vibheshmodgil/gimbal/docs/live_probe_pan_left.jpg

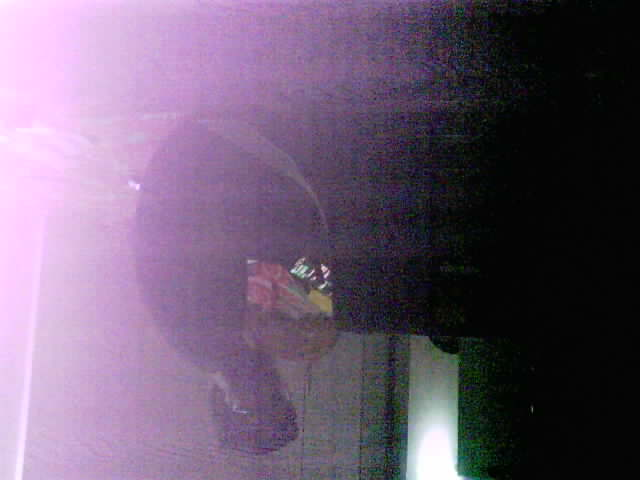
docs/live_probe_pan_left.jpg
