vibheshmodgil/gimbal/docs/live_probe_tilt_up.jpg

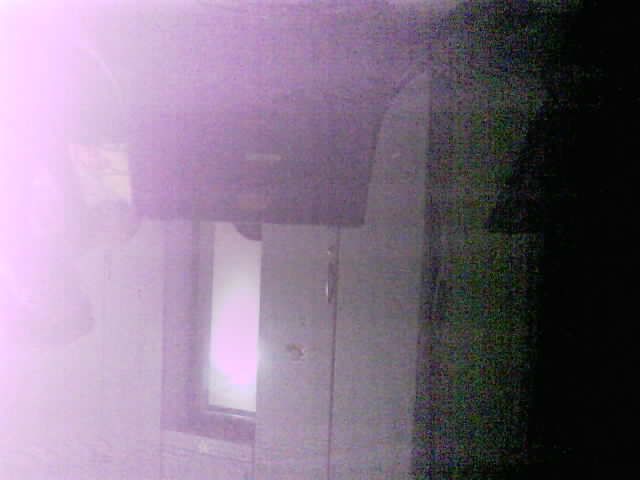
docs/live_probe_tilt_up.jpg
