vibheshmodgil/gimbal/docs/live_probe_frame.jpg

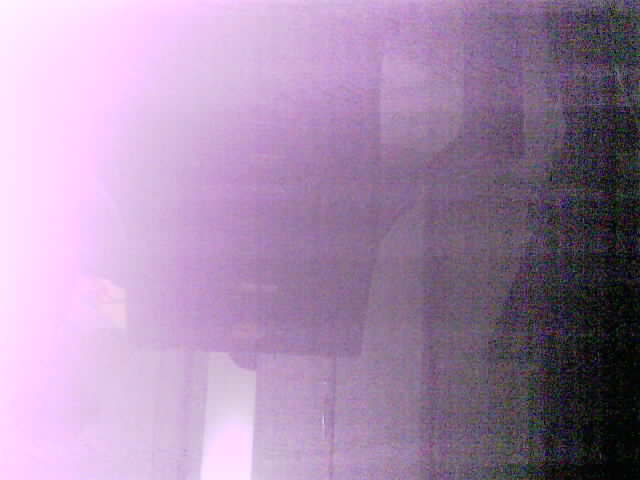
docs/live_probe_frame.jpg
