vibheshmodgil/gimbal/docs/live_probe_pan_right.jpg

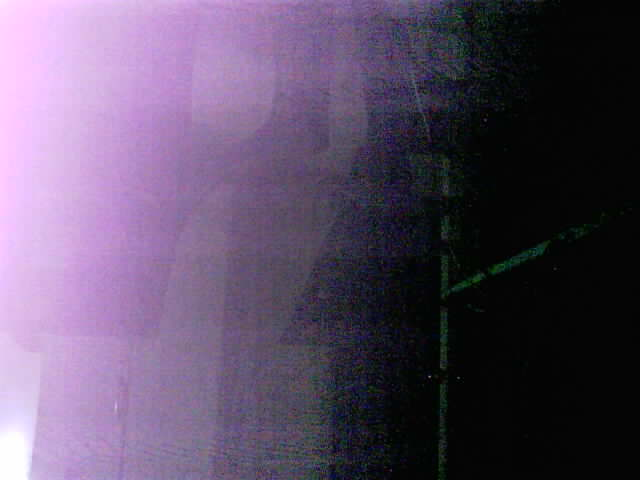
docs/live_probe_pan_right.jpg
