vibheshmodgil/gimbal/docs/previews/preview.png

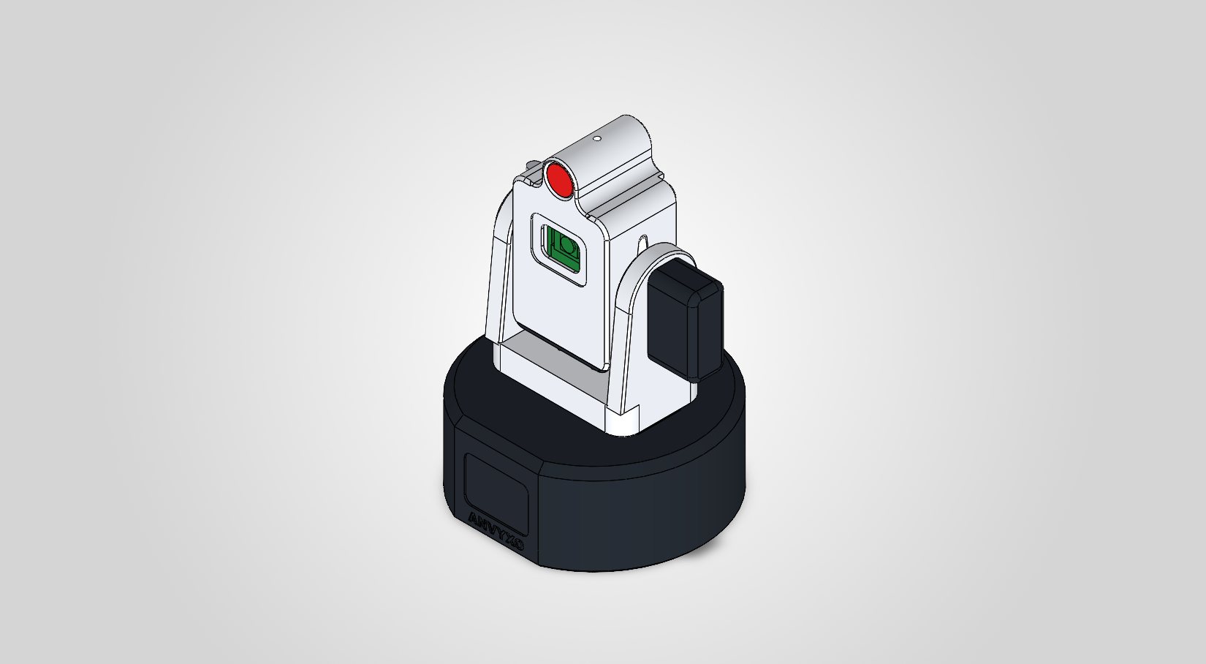
docs/previews/preview.png
