vibheshmodgil/gimbal/docs/previews/preview_back.png

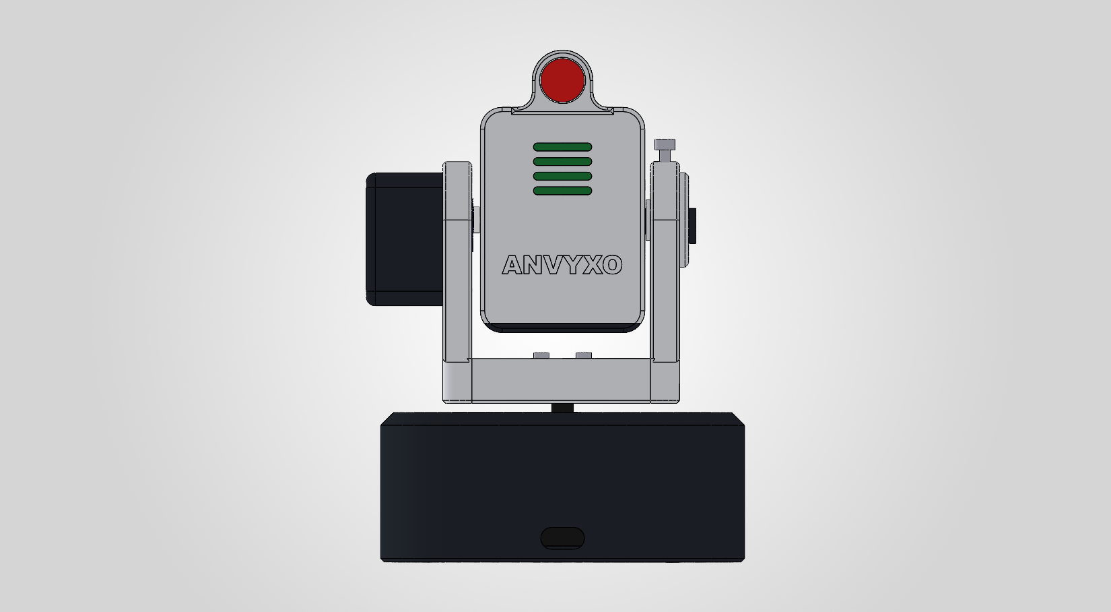
docs/previews/preview_back.png
