vibheshmodgil/gimbal/docs/previews/preview_exploded.png

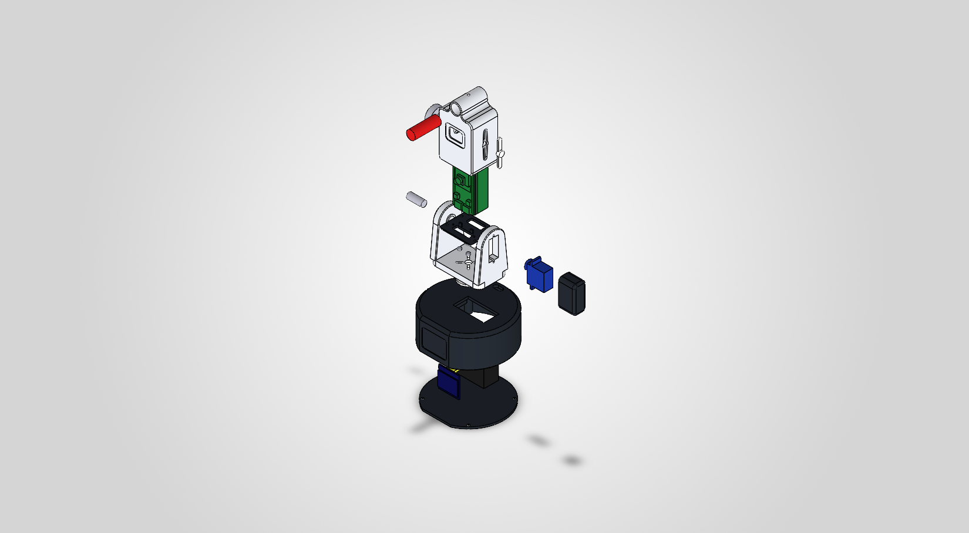
docs/previews/preview_exploded.png
