vibheshmodgil/gimbal/docs/previews/preview_front.png

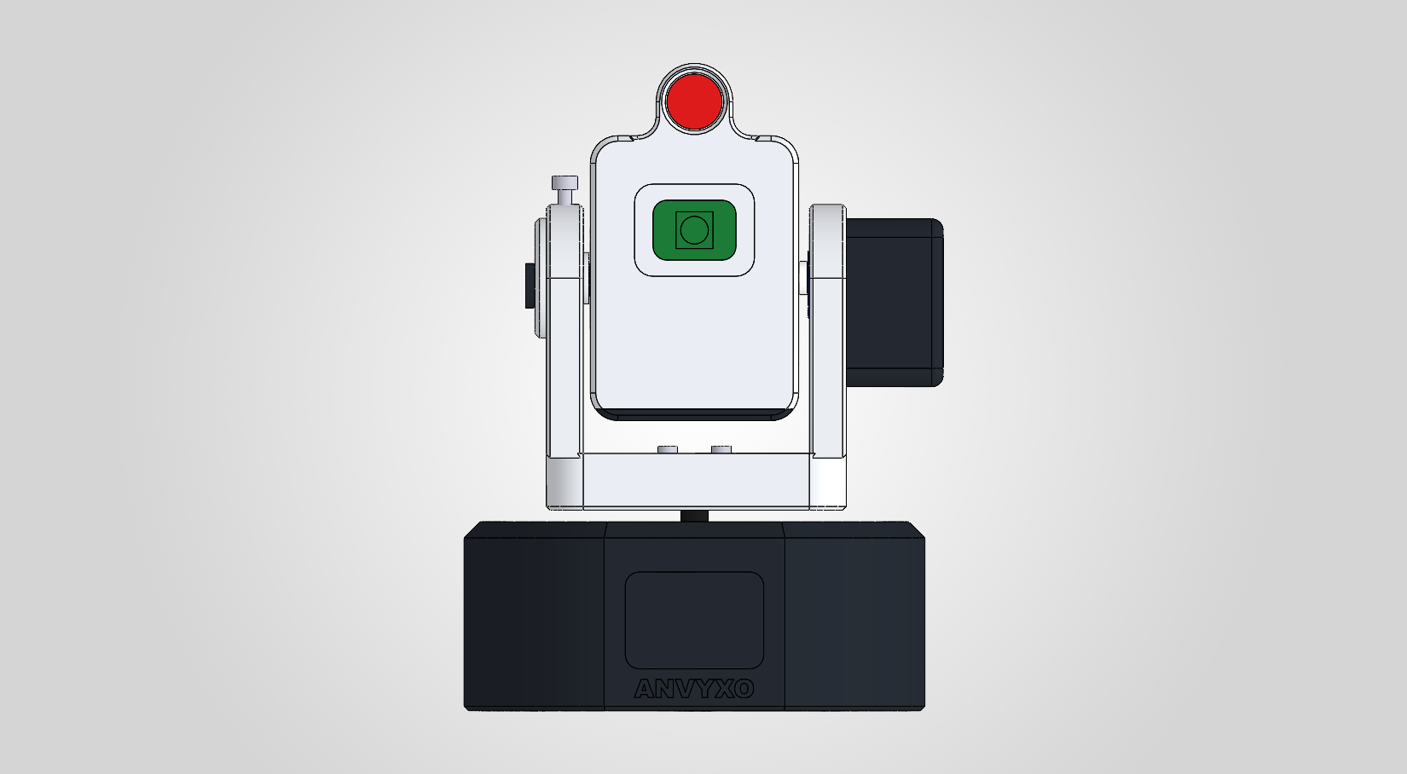
docs/previews/preview_front.png
