vibheshmodgil/gimbal/STEP/gimbal_assembly.step

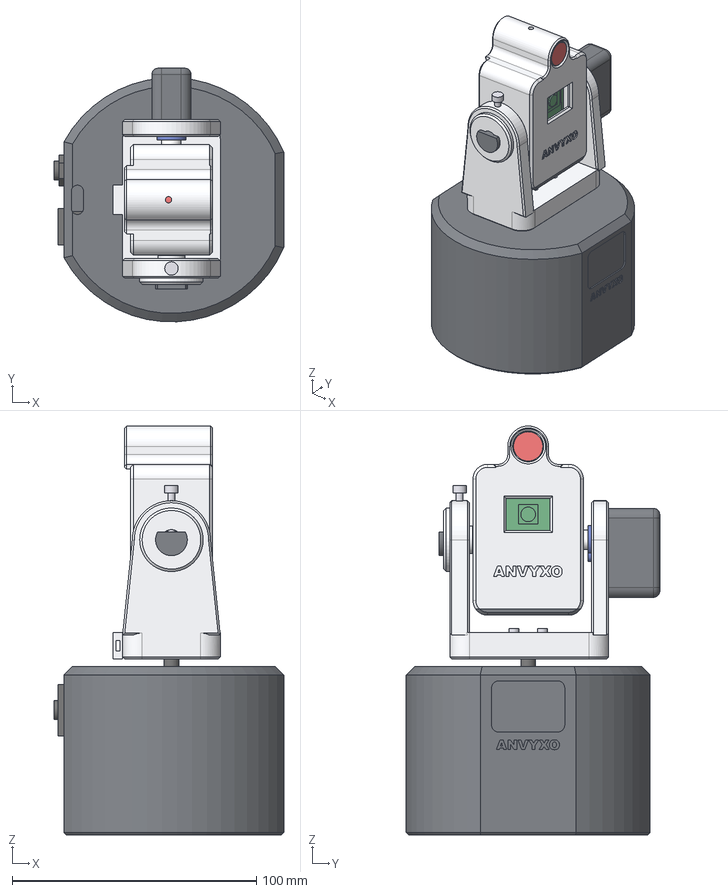
[picture p9: CAD file, 2026-10-19]
STEP/gimbal_assembly.step
94.0 x 103.8 x 167.5 mm
base
bottom_plate
yoke
servo_cap
axle_pin
head
head_floor
BUY_MG996R
BUY_MG996R_horn
BUY_horn_screws
BUY_MG90S
BUY_MG90S_horn
BUY_608ZZ
BUY_M3_lock_screw
BUY_laser_12mm
BUY_ESP32S3_CAM
BUY_OLED_096
BUY_OLED_header_dupont
BUY_battery_3S_BMS
BUY_buck_5V
BUY_WAGO_x2
BUY_cap_1000uF
BUY_rocker_switch
BUY_dc_jack
BUY_dc_jack_nut
