vibheshmodgil/gimbal/PRINT_BambuLab/5_REPRINT_axle_pin_A1.3mf

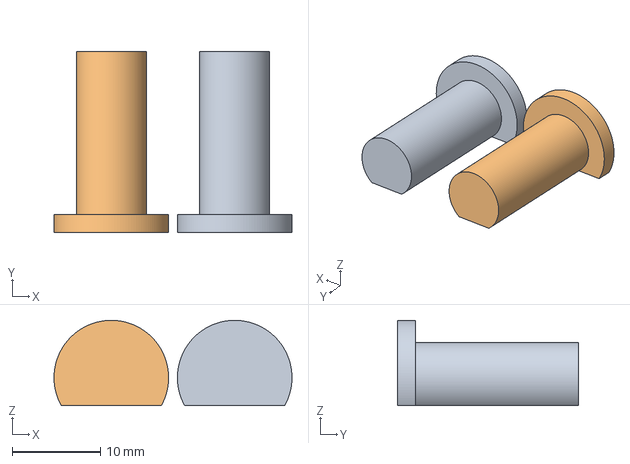
[picture p10: CAD file, 2026-10-19]
PRINT_BambuLab/5_REPRINT_axle_pin_A1.3mf
27.0 x 20.5 x 9.68 mm
stl_oriented/axle_pin.stl x 2
