vibheshmodgil/gimbal/PRINT_BambuLab/other_printers_geometry_only/plate1_fit_tests_any_colour.3mf

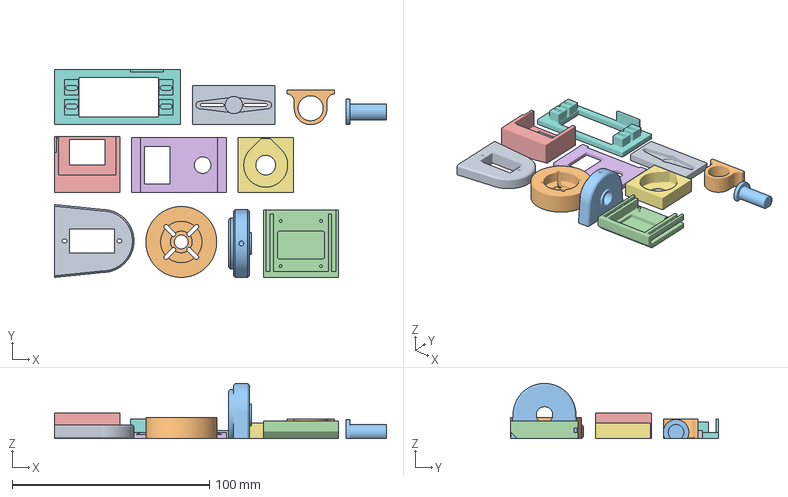
[picture p11: CAD file, 2026-10-19]
PRINT_BambuLab/other_printers_geometry_only/plate1_fit_tests_any_colour.3mf
168.5 x 105.5 x 28.0 mm
fit_tilt_servo_arm
fit_pan_horn
fit_axle_arm
fit_screen
fit_board_top_antenna_camera
fit_back_panel
fit_608_pocket
fit_pan_servo_deck
fit_horn_pocket
fit_laser_bore
axle_pin
