vibheshmodgil/gimbal/PRINT_BambuLab/stl_oriented/axle_pin.stl

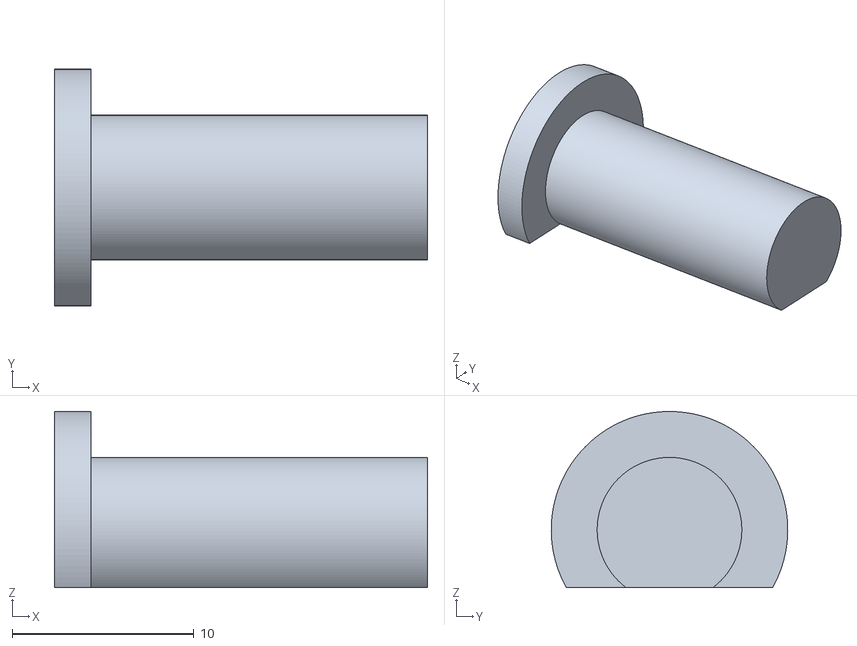
[picture p12: CAD file, 2026-10-19]
PRINT_BambuLab/stl_oriented/axle_pin.stl
20.5 x 13.0 x 9.68
