vibheshmodgil/gimbal/vendor_models/SG90_MG90S_servo_FreeCAD.step

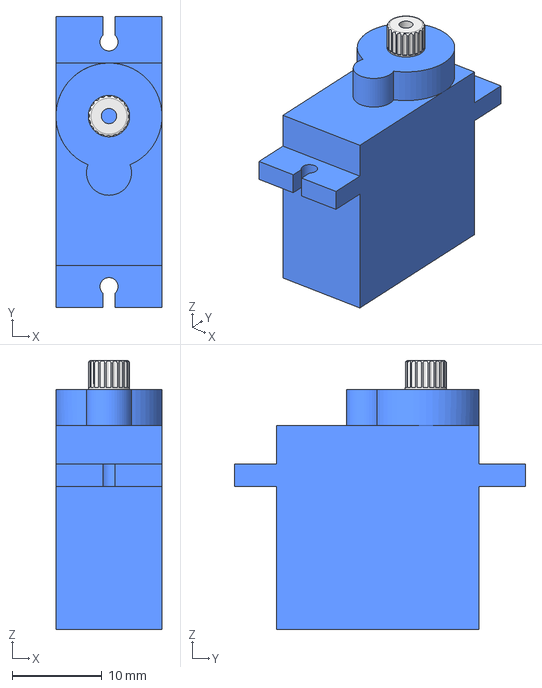
[picture p13: CAD file, 2026-10-19]
vendor_models/SG90_MG90S_servo_FreeCAD.step
11.8 x 32.4 x 29.9 mm
