vibheshmodgil/gimbal/PRINT_BambuLab/1_fit_test_round3_A1.3mf

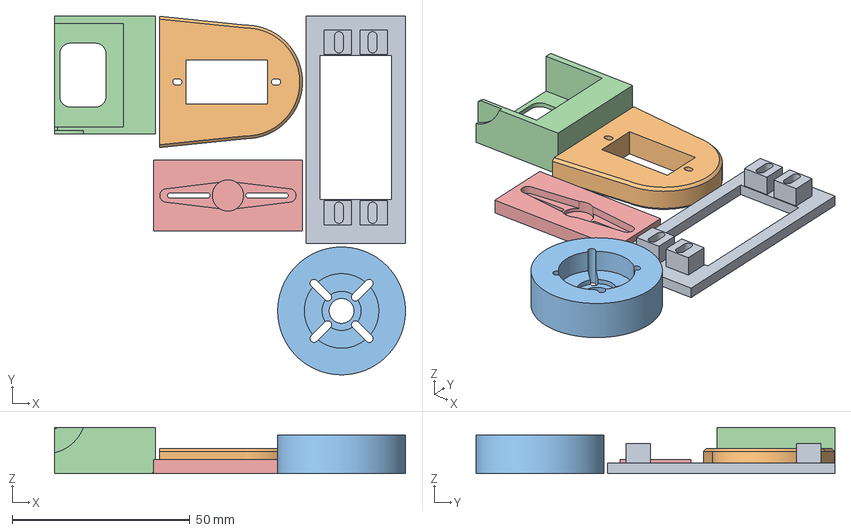
[picture p14: CAD file, 2026-10-19]
PRINT_BambuLab/1_fit_test_round3_A1.3mf
98.8 x 101.0 x 13.0 mm
fit_pan_servo_deck.stl
fit_tilt_servo_arm.stl
fit_pan_horn.stl
fit_board_top_antenna_camera.stl
fit_horn_pocket.stl
