vibheshmodgil/gimbal/PRINT_BambuLab/other_printers_geometry_only/plate3_dark_base_servo_cap.3mf

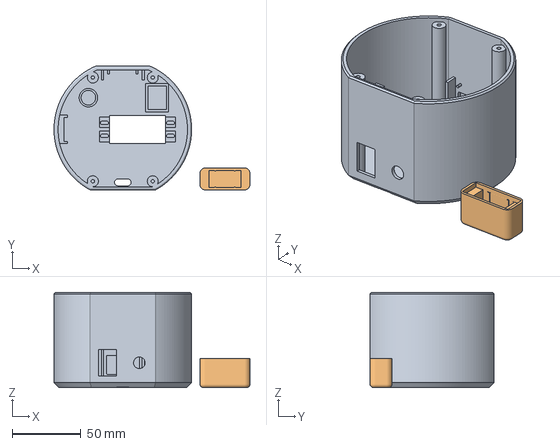
[picture p15: CAD file, 2026-10-19]
PRINT_BambuLab/other_printers_geometry_only/plate3_dark_base_servo_cap.3mf
142.4 x 90.0 x 69.1 mm
base
servo_cap
