vibheshmodgil/gimbal/PRINT_BambuLab/stl_oriented/head.stl

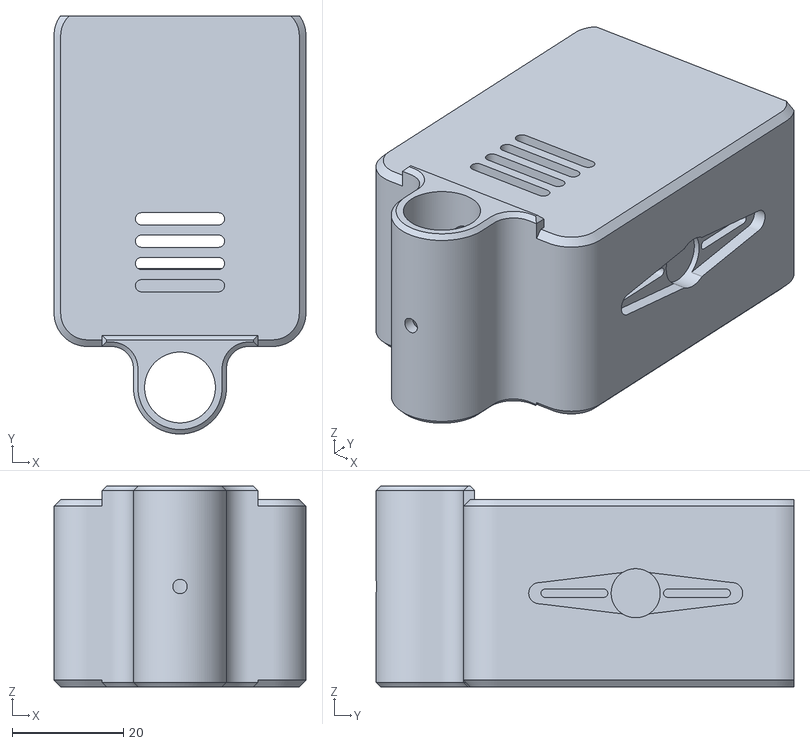
[picture p16: CAD file, 2026-10-19]
PRINT_BambuLab/stl_oriented/head.stl
45.2 x 75.0 x 36.0
