vibheshmodgil/gimbal/STL/fit_test/fit_laser_bore.stl

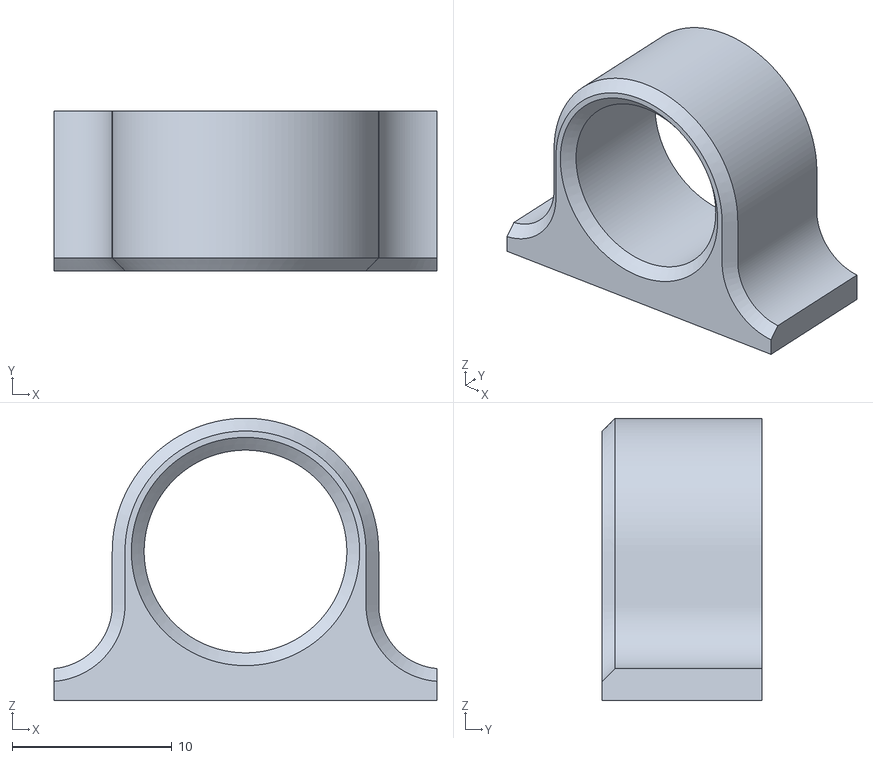
[picture p17: CAD file, 2026-10-19]
STL/fit_test/fit_laser_bore.stl
24.0 x 10.00 x 17.7
