vibheshmodgil/gimbal/vendor_models/SG90_MG90S_2arm_horn_FreeCAD.step

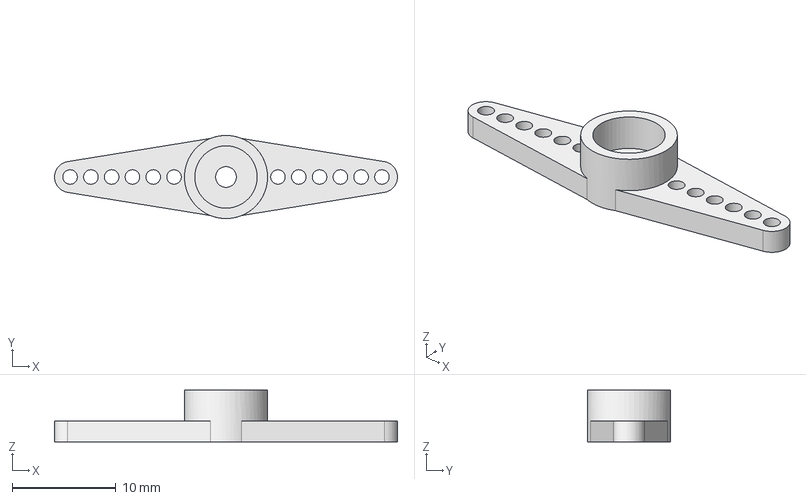
[picture p18: CAD file, 2026-10-19]
vendor_models/SG90_MG90S_2arm_horn_FreeCAD.step
33.0 x 8.00 x 5.00 mm
