vibheshmodgil/gimbal/PRINT_BambuLab/4_FINAL_bottom_plate_A1.3mf

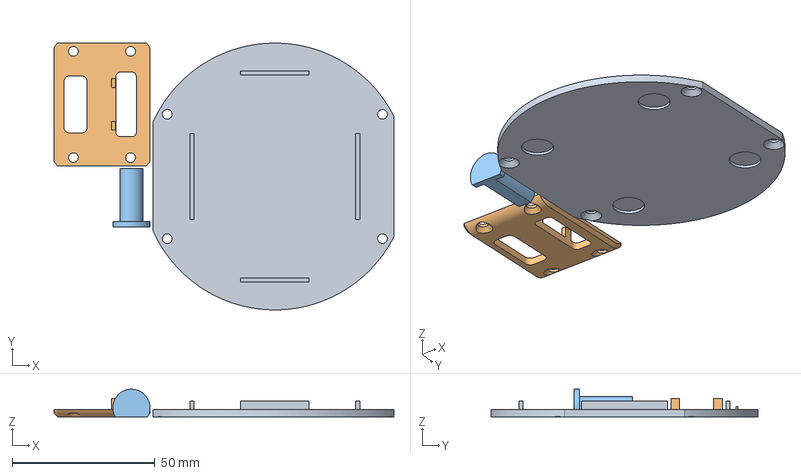
[picture p19: CAD file, 2026-10-19]
PRINT_BambuLab/4_FINAL_bottom_plate_A1.3mf
119.0 x 93.4 x 9.68 mm
stl_oriented/bottom_plate.stl
stl_oriented/head_floor.stl
stl_oriented/axle_pin.stl
