vibheshmodgil/gimbal/PRINT_BambuLab/other_printers_geometry_only/plate2_light_head_yoke.3mf

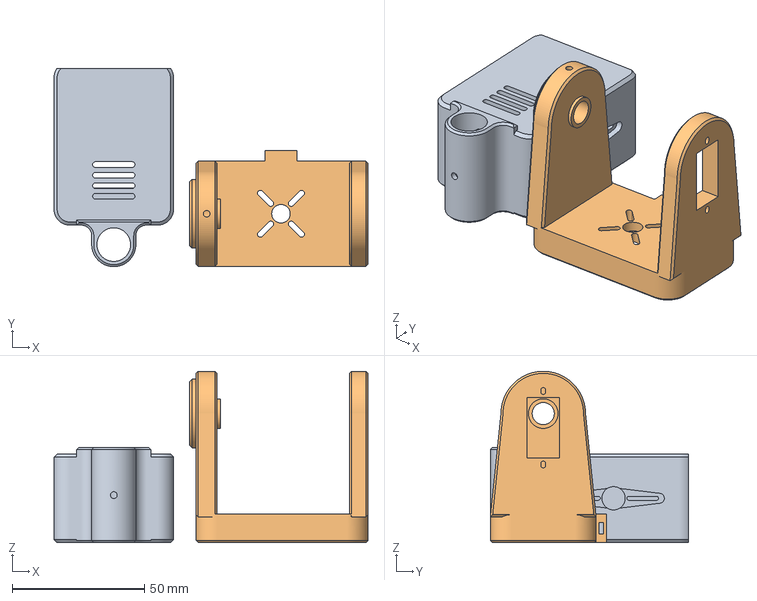
[picture p20: CAD file, 2026-10-19]
PRINT_BambuLab/other_printers_geometry_only/plate2_light_head_yoke.3mf
118.7 x 75.0 x 64.8 mm
head
yoke
