vibheshmodgil/gimbal/PRINT_BambuLab/stl_oriented/fit_pan_servo_deck.stl

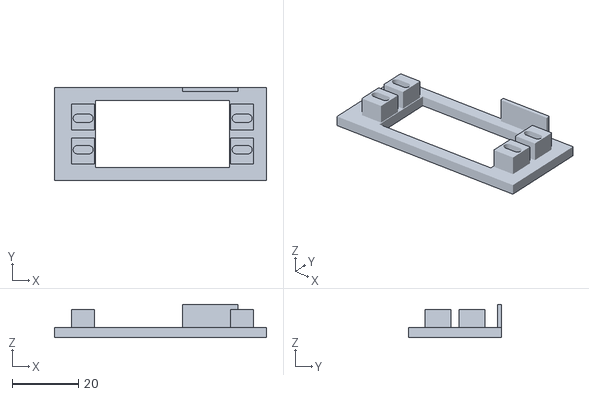
[picture p21: CAD file, 2026-10-19]
PRINT_BambuLab/stl_oriented/fit_pan_servo_deck.stl
64.0 x 28.0 x 10.0
