vibheshmodgil/gimbal/STEP/servo_cap.step

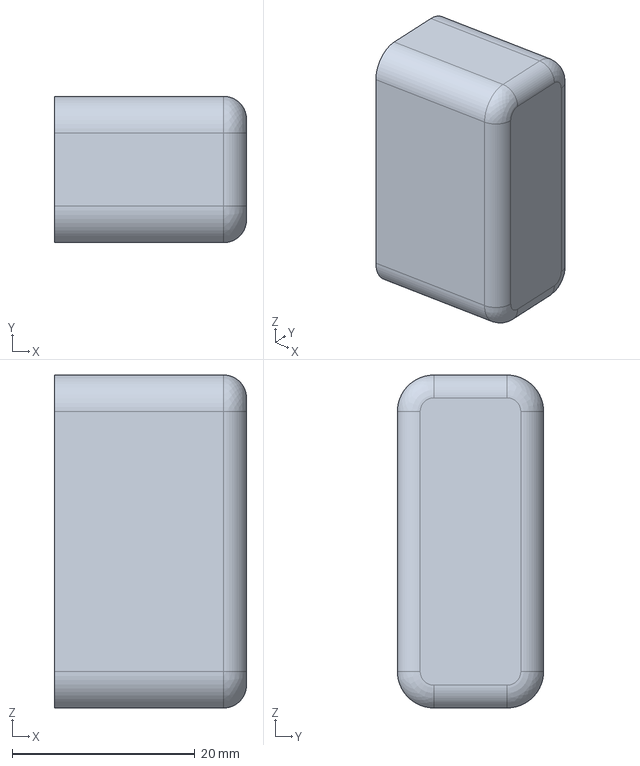
[picture p22: CAD file, 2026-10-19]
STEP/servo_cap.step
21.0 x 16.0 x 36.4 mm
