vibheshmodgil/gimbal/STL/fit_test/fit_tilt_servo_arm.stl

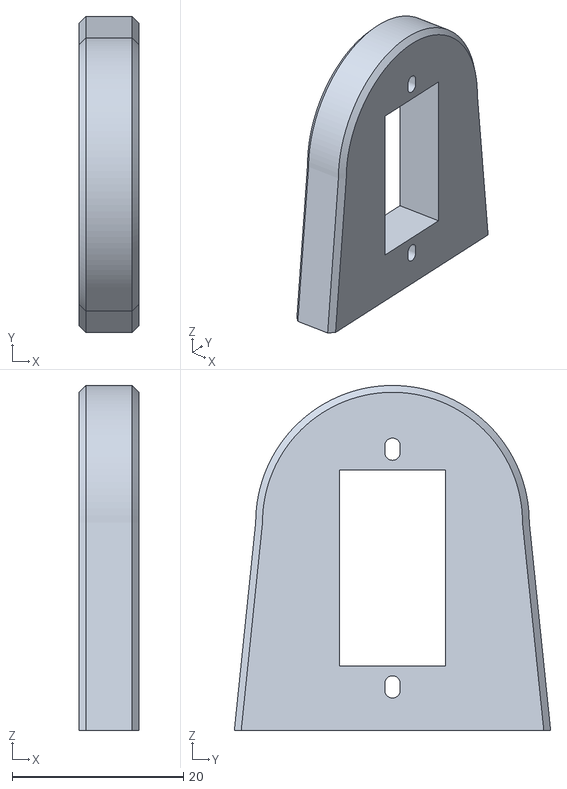
[picture p23: CAD file, 2026-10-19]
STL/fit_test/fit_tilt_servo_arm.stl
7.00 x 37.0 x 40.3
