vibheshmodgil/gimbal/PRINT_BambuLab/2_FINAL_head_yoke_A1.3mf

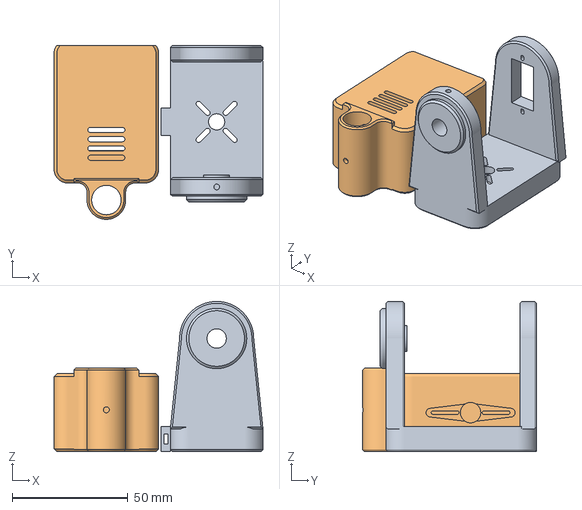
[picture p24: CAD file, 2026-10-19]
PRINT_BambuLab/2_FINAL_head_yoke_A1.3mf
90.2 x 75.0 x 64.8 mm
stl_oriented/yoke.stl
stl_oriented/head.stl
