vibheshmodgil/gimbal/PRINT_BambuLab/other_printers_geometry_only/plate4_dark_bottom_plate_head_floor.3mf

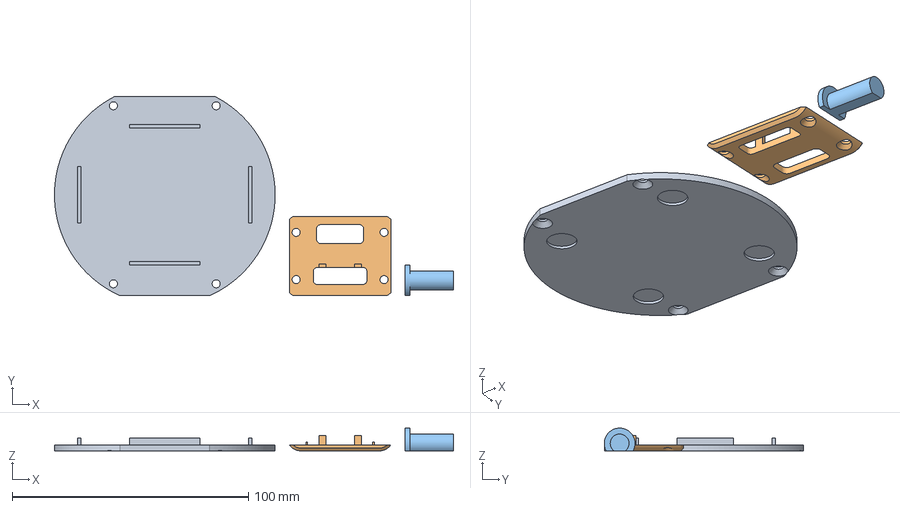
[picture p25: CAD file, 2026-10-19]
PRINT_BambuLab/other_printers_geometry_only/plate4_dark_bottom_plate_head_floor.3mf
168.9 x 84.4 x 9.68 mm
bottom_plate
head_floor
axle_pin
