vibheshmodgil/gimbal/PRINT_BambuLab/stl_oriented/head_floor.stl

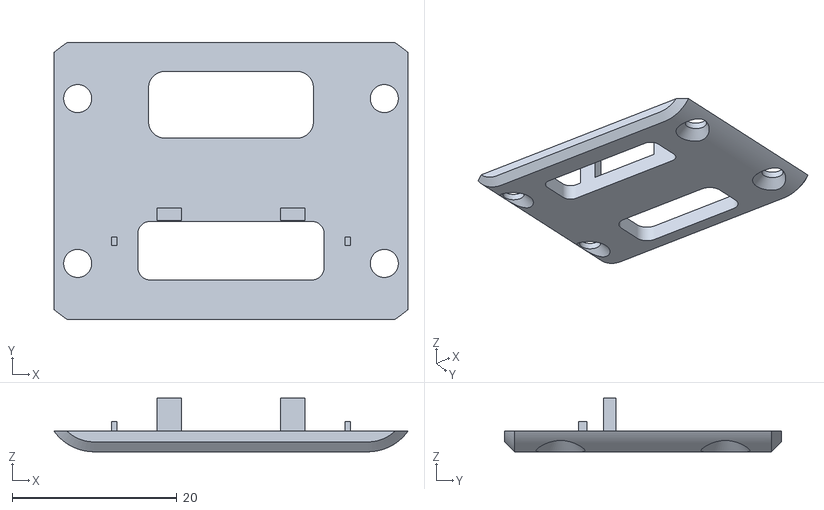
[picture p26: CAD file, 2026-10-19]
PRINT_BambuLab/stl_oriented/head_floor.stl
42.9 x 33.6 x 6.50
