vibheshmodgil/gimbal/STEP/yoke.step

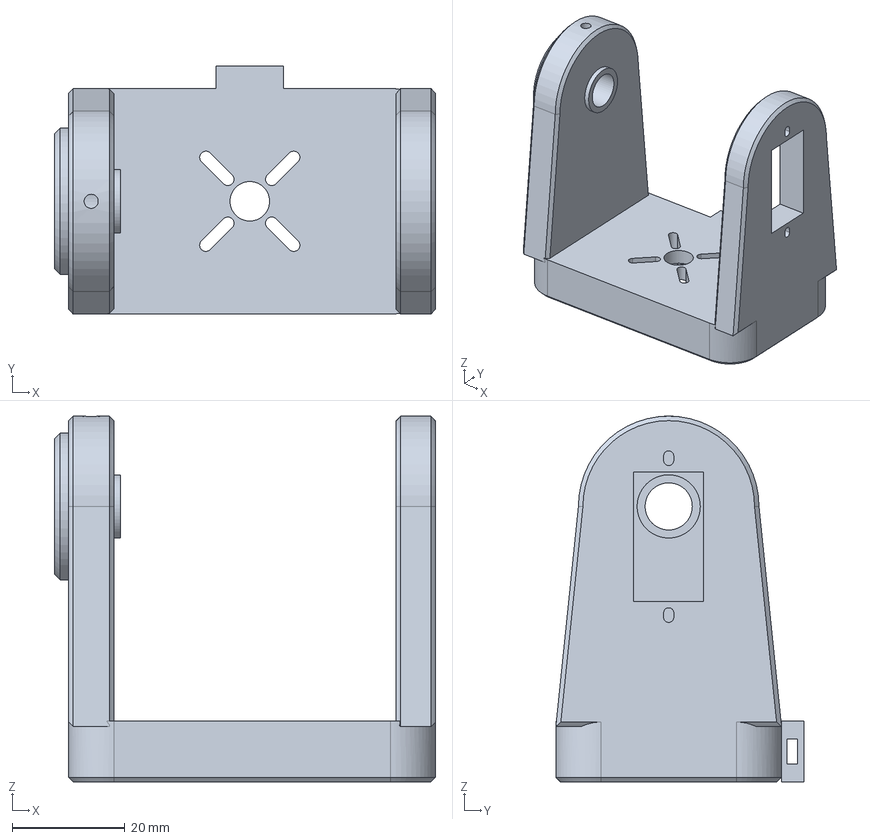
[picture p27: CAD file, 2026-10-19]
STEP/yoke.step
67.5 x 44.0 x 64.8 mm
