vibheshmodgil/gimbal/STL/fit_test/fit_screen.stl

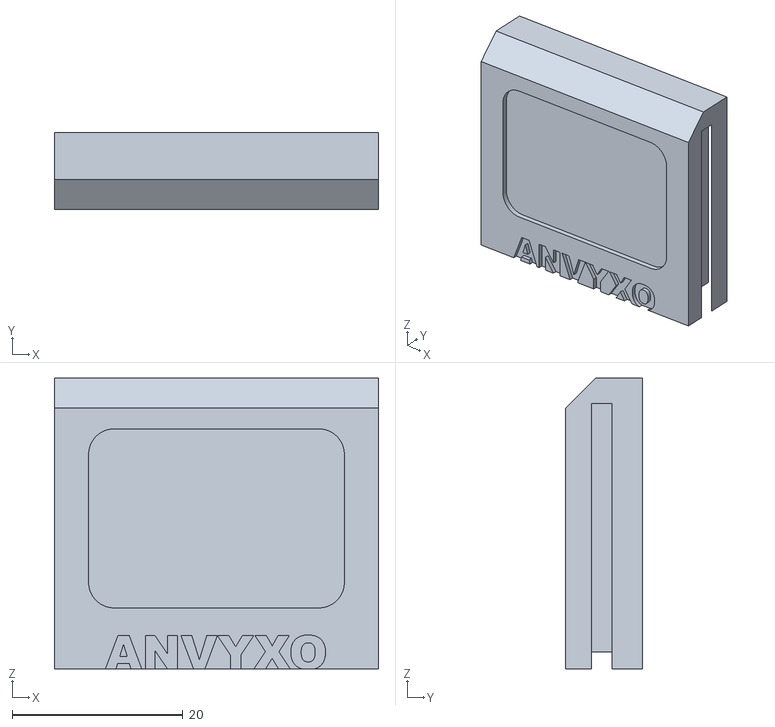
[picture p28: CAD file, 2026-10-19]
STL/fit_test/fit_screen.stl
38.0 x 9.00 x 34.1
