vibheshmodgil/gimbal/PRINT_BambuLab/3_FINAL_base_A1.3mf

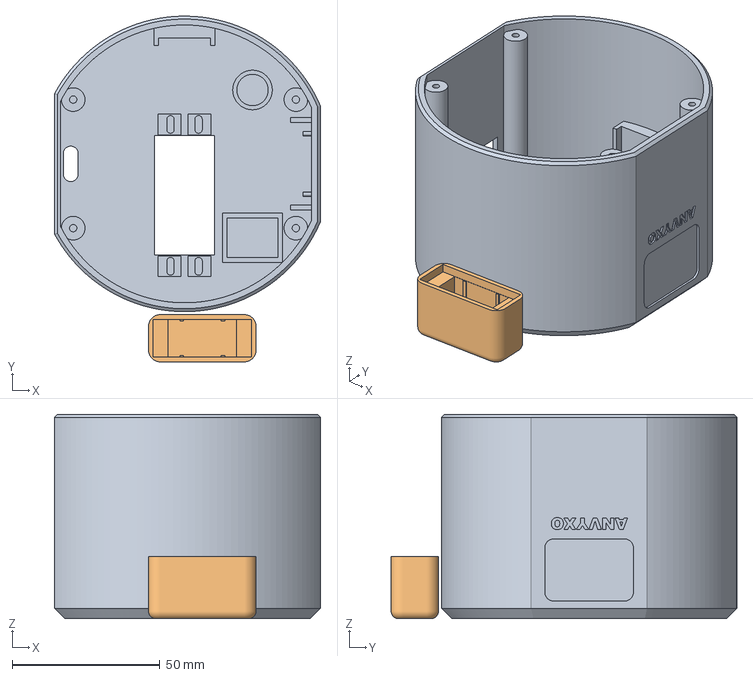
[picture p29: CAD file, 2026-10-19]
PRINT_BambuLab/3_FINAL_base_A1.3mf
90.0 x 117.0 x 69.1 mm
stl_oriented/base.stl
stl_oriented/servo_cap.stl
