vibheshmodgil/gimbal/PRINT_BambuLab/stl_oriented/bottom_plate.stl

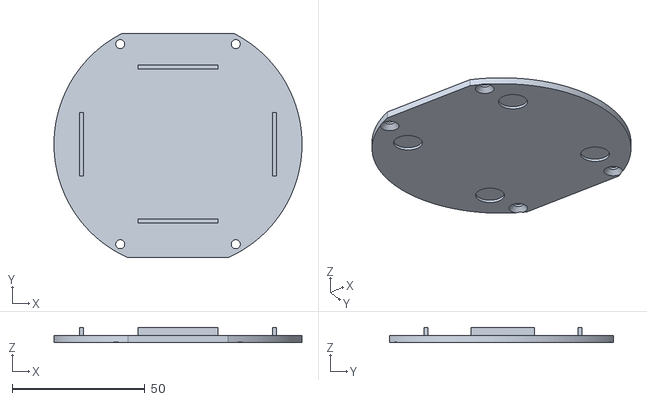
[picture p30: CAD file, 2026-10-19]
PRINT_BambuLab/stl_oriented/bottom_plate.stl
93.4 x 84.4 x 5.50
