vibheshmodgil/gimbal/STEP/base.step

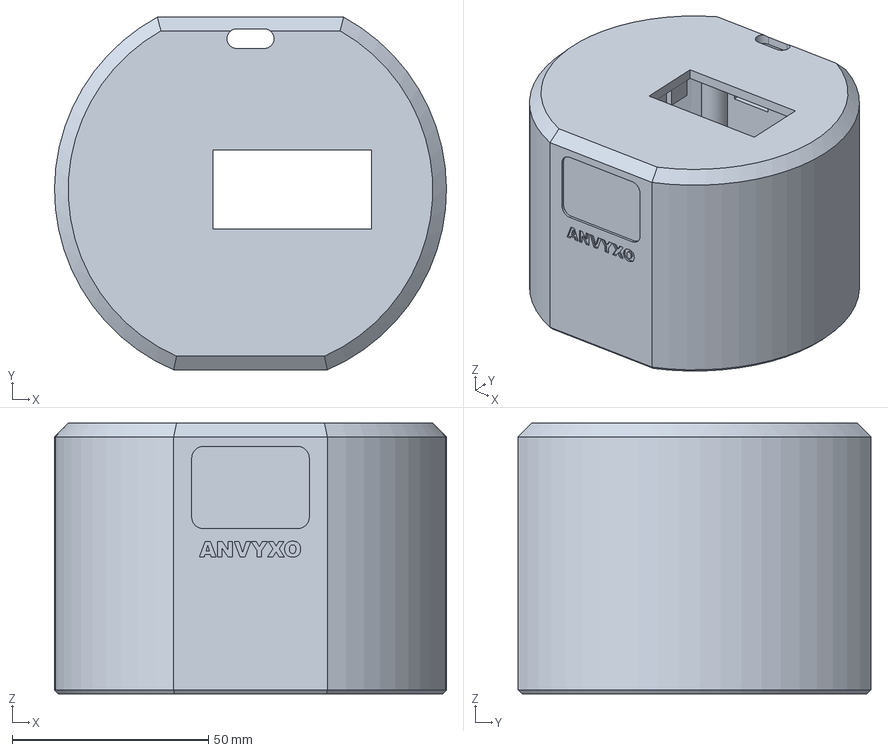
[picture p31: CAD file, 2026-10-19]
STEP/base.step
100.0 x 90.0 x 69.1 mm
