vibheshmodgil/gimbal/STL/fit_test/fit_horn_pocket.stl

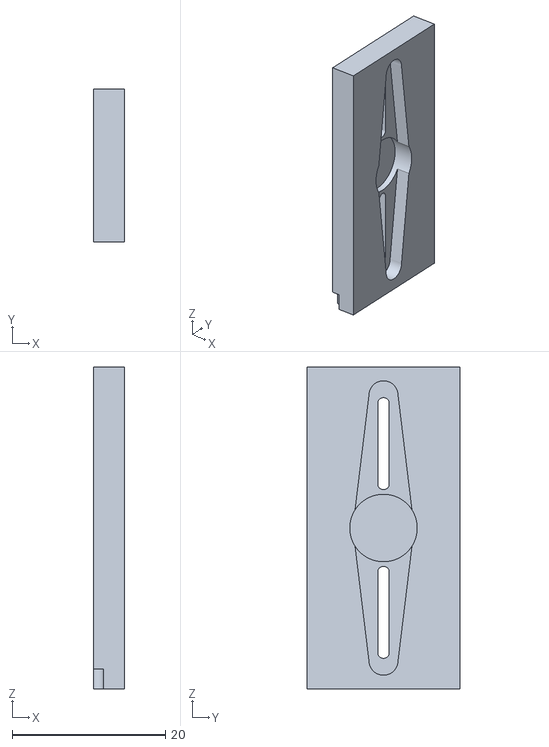
[picture p32: CAD file, 2026-10-19]
STL/fit_test/fit_horn_pocket.stl
4.00 x 20.0 x 42.0
