vibheshmodgil/gimbal/PRINT_BambuLab/1_fit_test_round4_A1.3mf

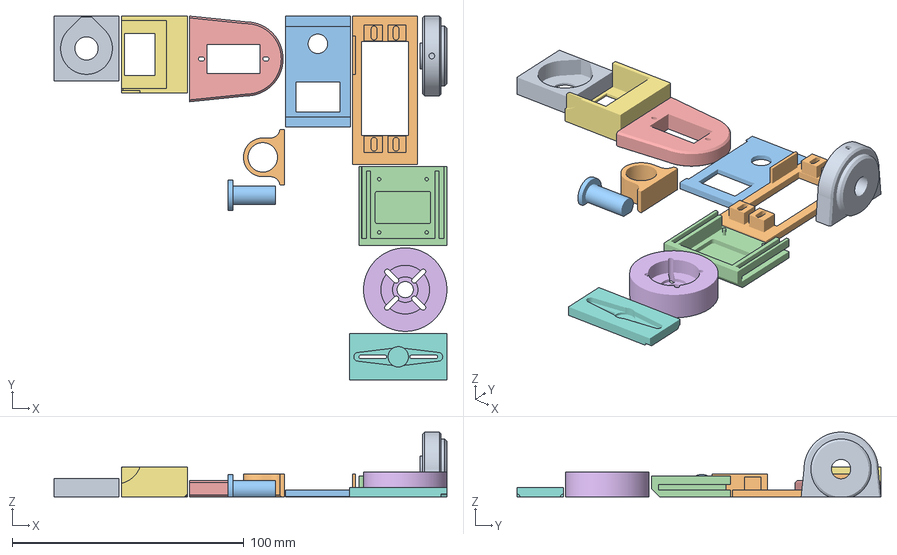
[picture p33: CAD file, 2026-10-19]
PRINT_BambuLab/1_fit_test_round4_A1.3mf
169.5 x 157.1 x 28.0 mm
stl_oriented/fit_axle_arm.stl
stl_oriented/fit_pan_servo_deck.stl
stl_oriented/fit_back_panel.stl
stl_oriented/fit_screen.stl
stl_oriented/fit_tilt_servo_arm.stl
stl_oriented/fit_pan_horn.stl
stl_oriented/fit_board_top_antenna_camera.stl
stl_oriented/fit_horn_pocket.stl
stl_oriented/fit_608_pocket.stl
stl_oriented/fit_laser_bore.stl
stl_oriented/axle_pin.stl
