vibheshmodgil/gimbal/PRINT_BambuLab/stl_oriented/fit_back_panel.stl

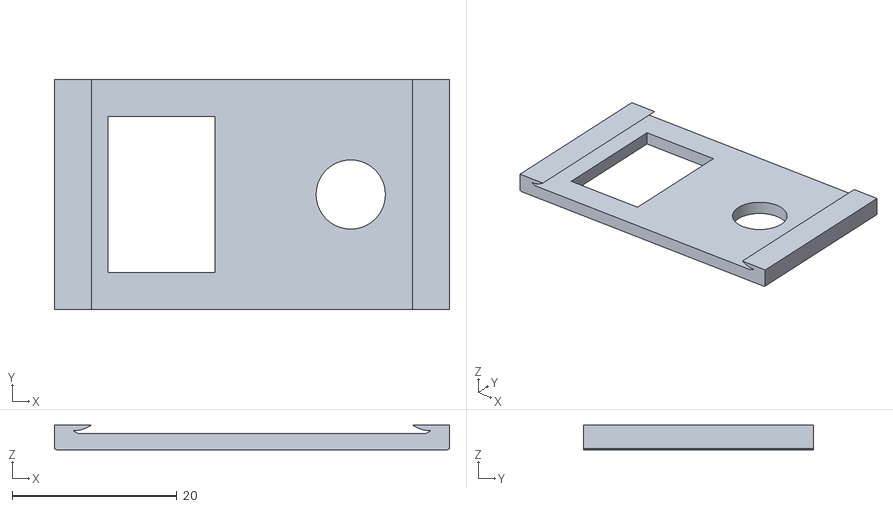
[picture p34: CAD file, 2026-10-19]
PRINT_BambuLab/stl_oriented/fit_back_panel.stl
48.0 x 28.0 x 3.00
