vibheshmodgil/gimbal/PRINT_BambuLab/stl_oriented/fit_608_pocket.stl

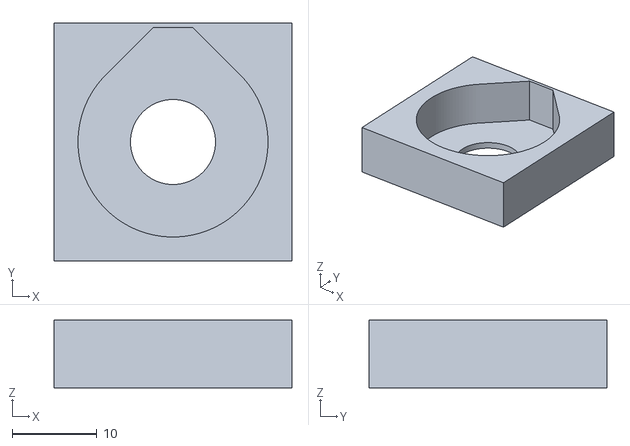
[picture p35: CAD file, 2026-10-19]
PRINT_BambuLab/stl_oriented/fit_608_pocket.stl
28.0 x 28.0 x 8.00
