vibheshmodgil/gimbal/STL/fit_test/fit_board_top_antenna_camera.stl

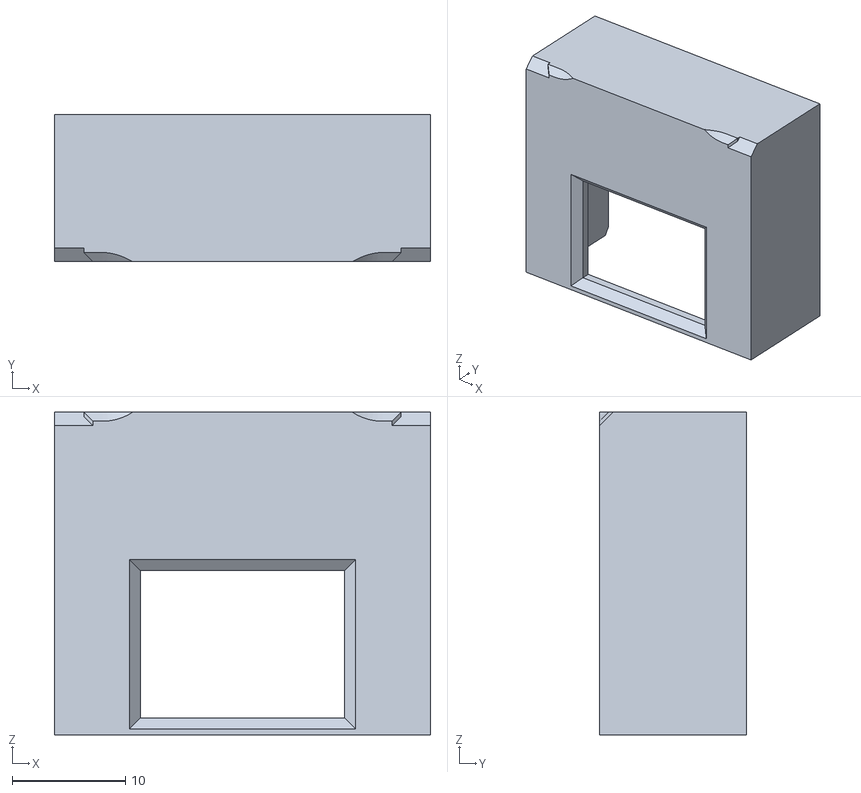
[picture p37: CAD file, 2026-10-19]
STL/fit_test/fit_board_top_antenna_camera.stl
33.2 x 13.0 x 28.5
