vibheshmodgil/gimbal/STL/fit_test/fit_pan_horn.stl

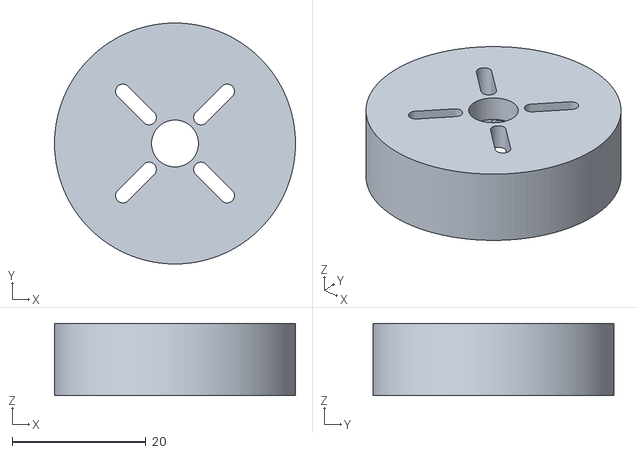
[picture p38: CAD file, 2026-10-19]
STL/fit_test/fit_pan_horn.stl
36.0 x 36.0 x 10.8
