vibheshmodgil/gimbal/STL/fit_test/fit_axle_arm.stl

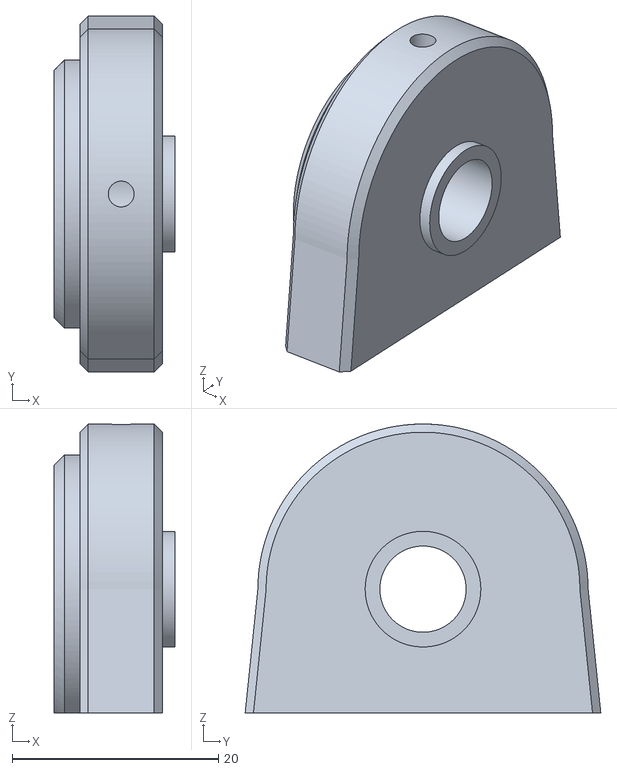
[picture p39: CAD file, 2026-10-19]
STL/fit_test/fit_axle_arm.stl
11.7 x 34.5 x 28.0
