vibheshmodgil/gimbal/(list of files, cad)

Other CAD files:
STEP/axle_pin.step
STL/fit_test/axle_pin.stl
STEP/head.step
STL/fit_test/fit_back_panel.stl
PRINT_BambuLab/stl_oriented/fit_tilt_servo_arm.stl
STEP/head_floor.step
PRINT_BambuLab/stl_oriented/fit_horn_pocket.stl
STEP/bottom_plate.step
STL/fit_test/fit_608_pocket.stl
PRINT_BambuLab/stl_oriented/fit_laser_bore.stl
STL/fit_test/fit_pan_servo_deck.stl
PRINT_BambuLab/stl_oriented/servo_cap.stl
PRINT_BambuLab/stl_oriented/yoke.stl
STL/fit_test/fit_head_floor_usb.stl
PRINT_BambuLab/stl_oriented/fit_head_floor_usb.stl
PRINT_BambuLab/stl_oriented/fit_pan_horn.stl
PRINT_BambuLab/stl_oriented/fit_axle_arm.stl
PRINT_BambuLab/stl_oriented/base.stl
PRINT_BambuLab/stl_oriented/fit_screen.stl
PRINT_BambuLab/stl_oriented/fit_board_top_antenna_camera.stl
STEP/gimbal_assembly.SLDASM
STL/axle_pin.stl
STL/base.stl
STL/bottom_plate.stl
STL/head.stl
STL/head_floor.stl
STL/servo_cap.stl
STL/yoke.stl
