vibheshmodgil/gimbal/docs/guides/ASSEMBLY_GUIDE_1_head.png

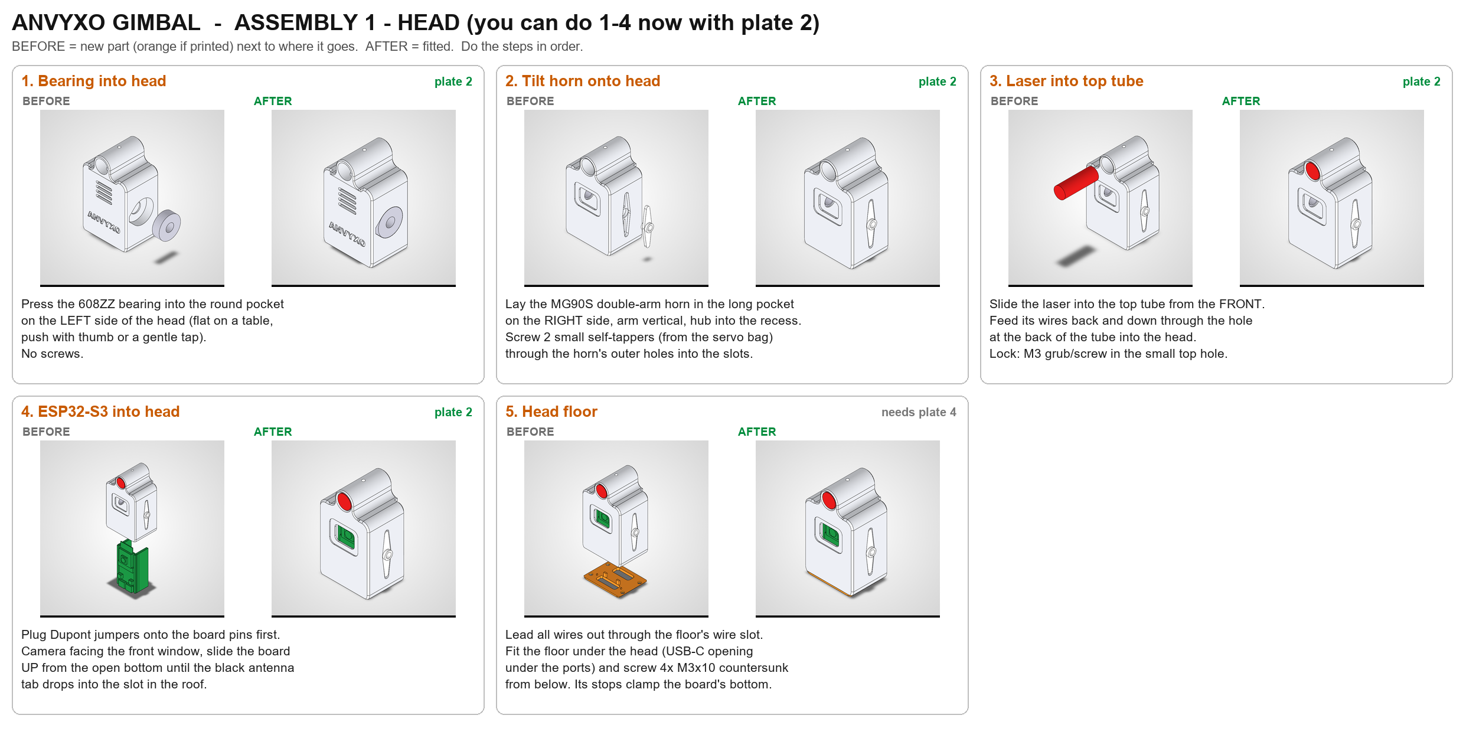
docs/guides/ASSEMBLY_GUIDE_1_head.png
