vibheshmodgil/gimbal/docs/guides/ASSEMBLY_GUIDE_2_base_and_final.png

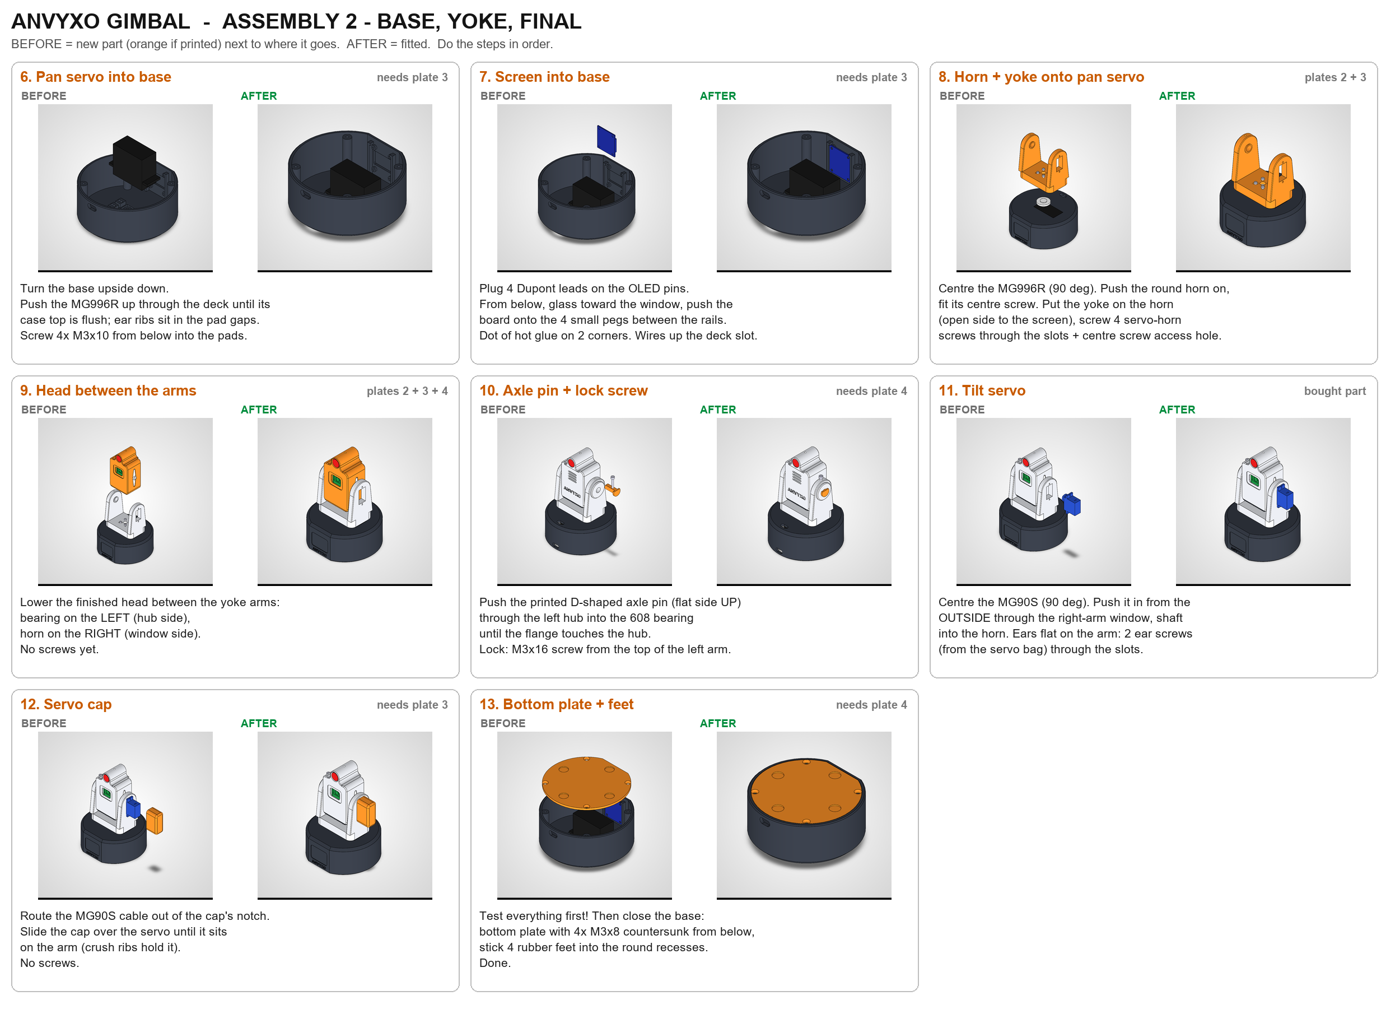
docs/guides/ASSEMBLY_GUIDE_2_base_and_final.png
