vibheshmodgil/gimbal/docs/guides/CHECK_SHEET_round2.png

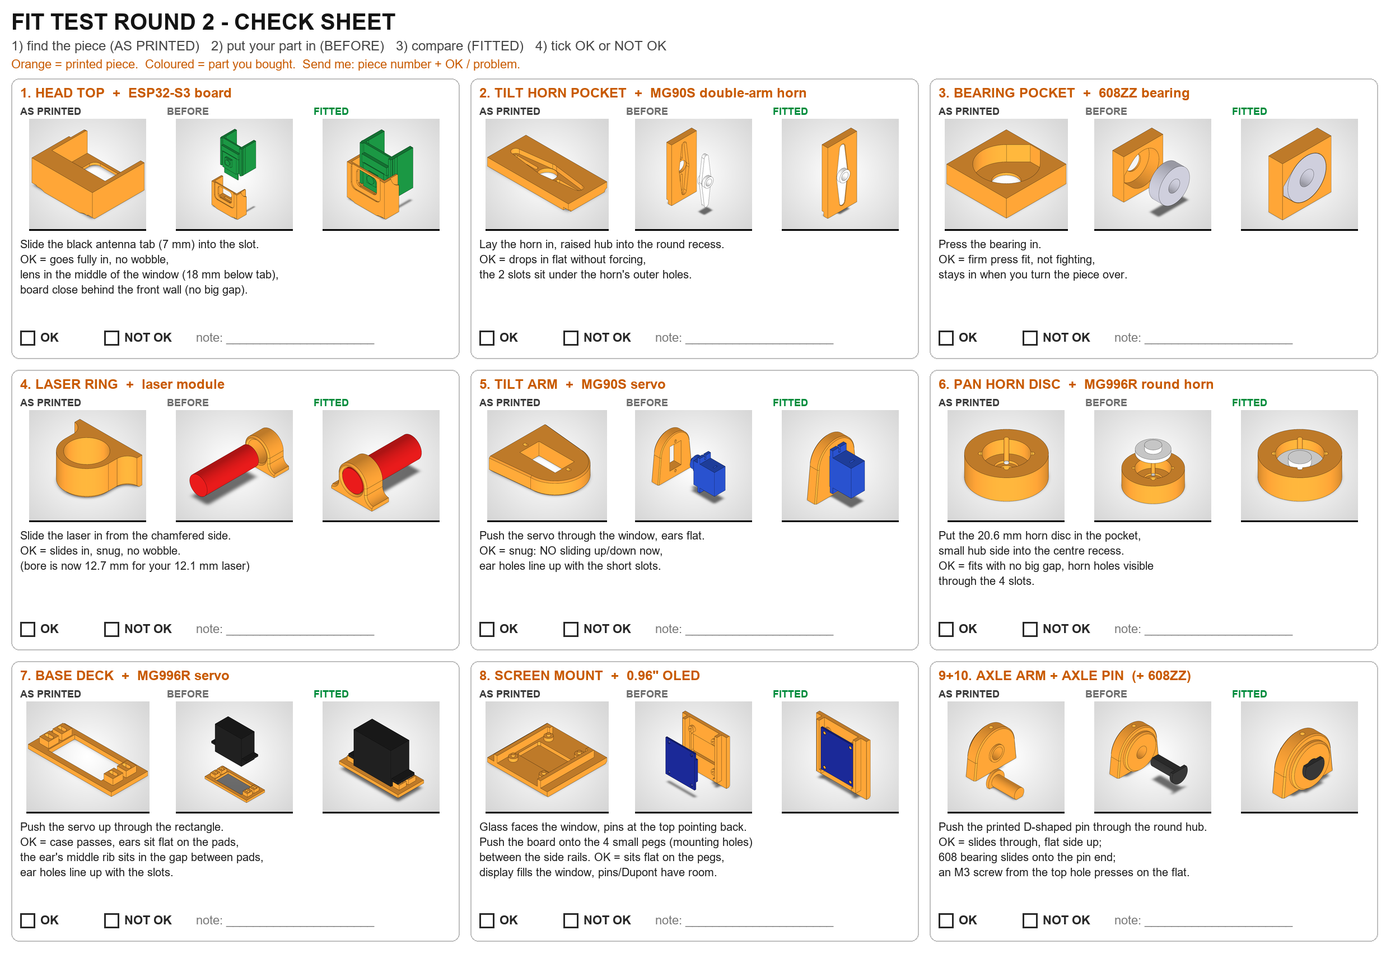
docs/guides/CHECK_SHEET_round2.png
