vibheshmodgil/gimbal/docs/guides/fit_test_guide.png

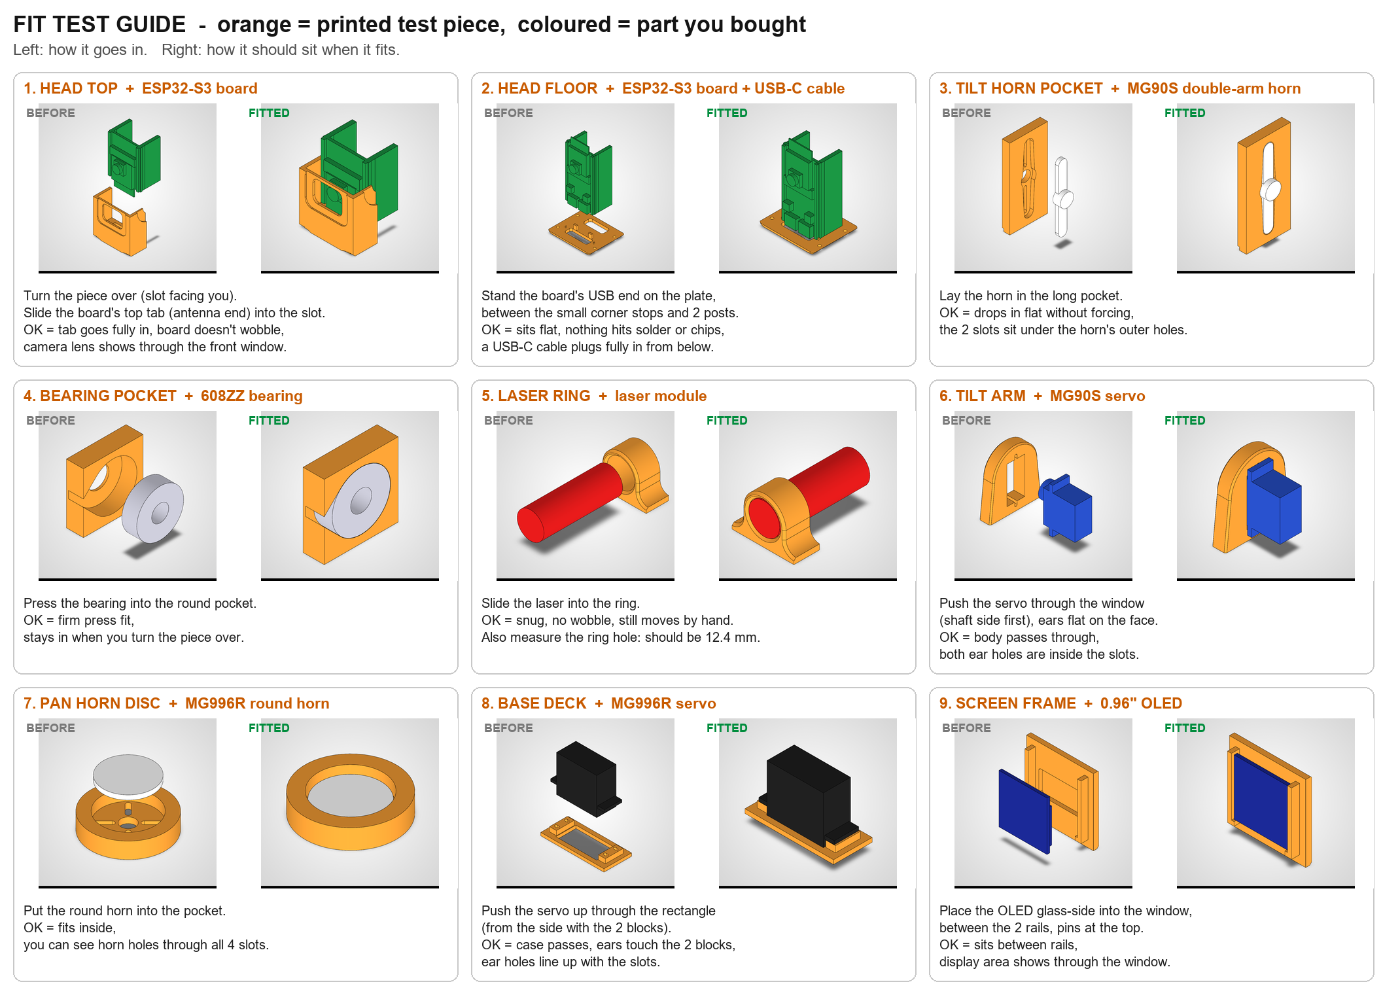
docs/guides/fit_test_guide.png
