vibheshmodgil/gimbal/docs/guides/FIT_TEST_GUIDE_round2.png

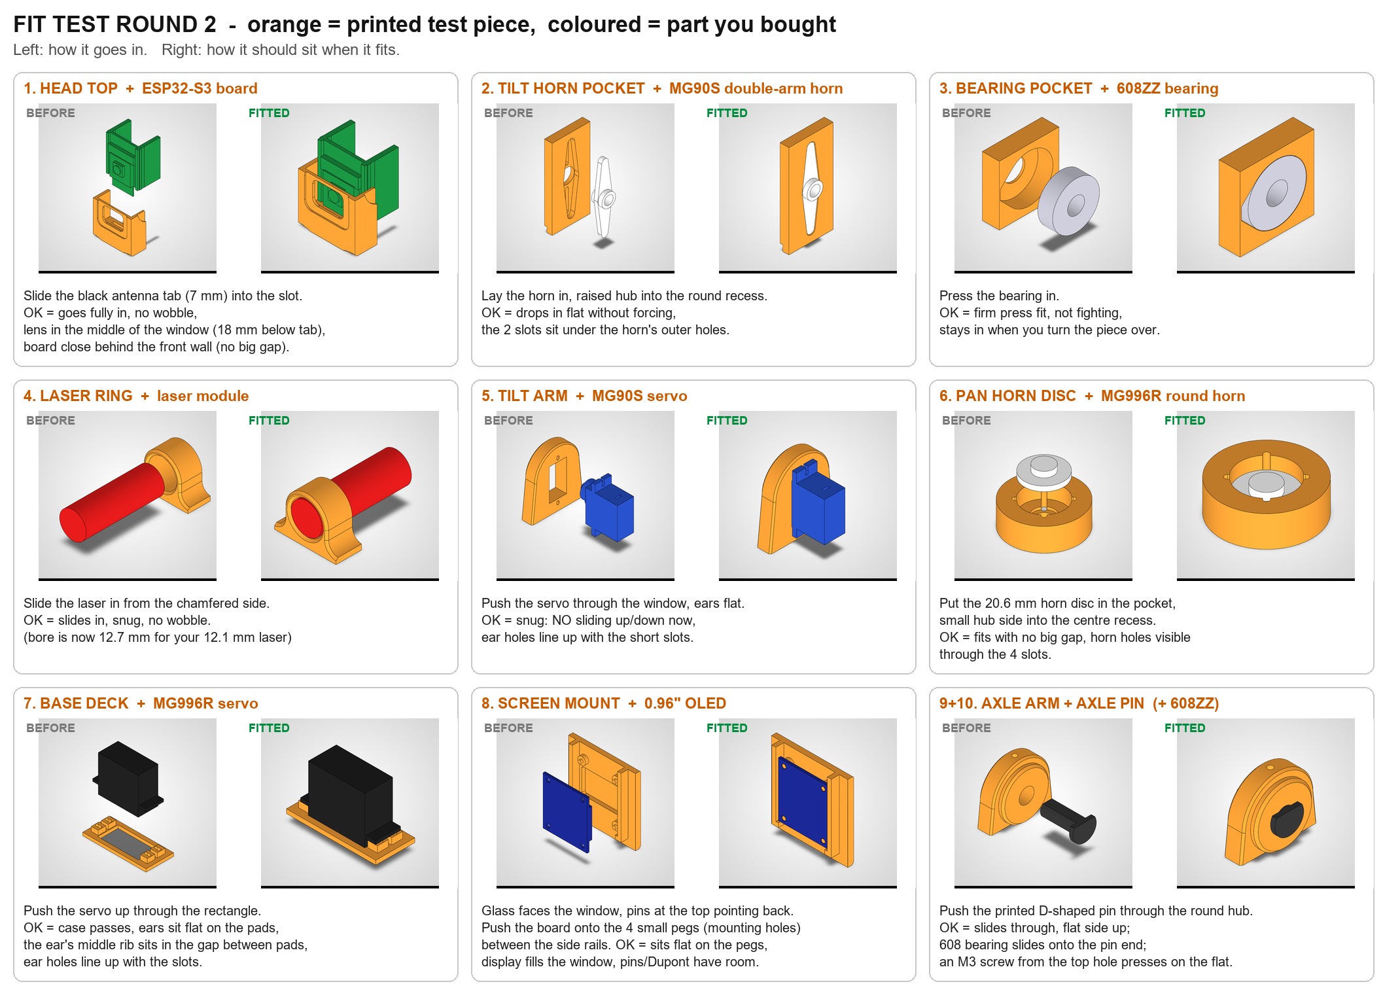
docs/guides/FIT_TEST_GUIDE_round2.png
