vibheshmodgil/gimbal/docs/guides/MEASURE_SHEET.png

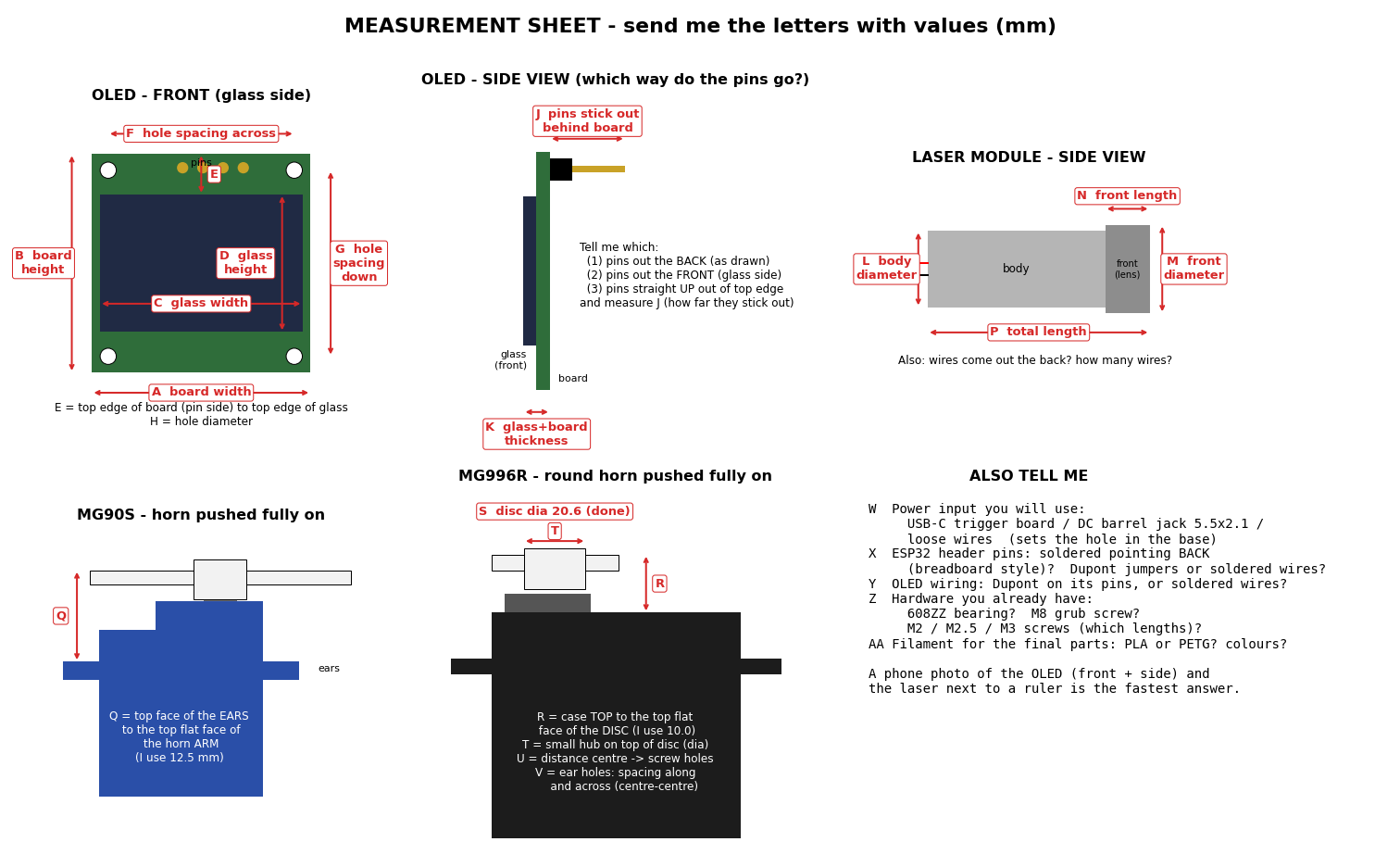
docs/guides/MEASURE_SHEET.png
