vibheshmodgil/gimbal/docs/guides/MEASURE_SHEET_2.png

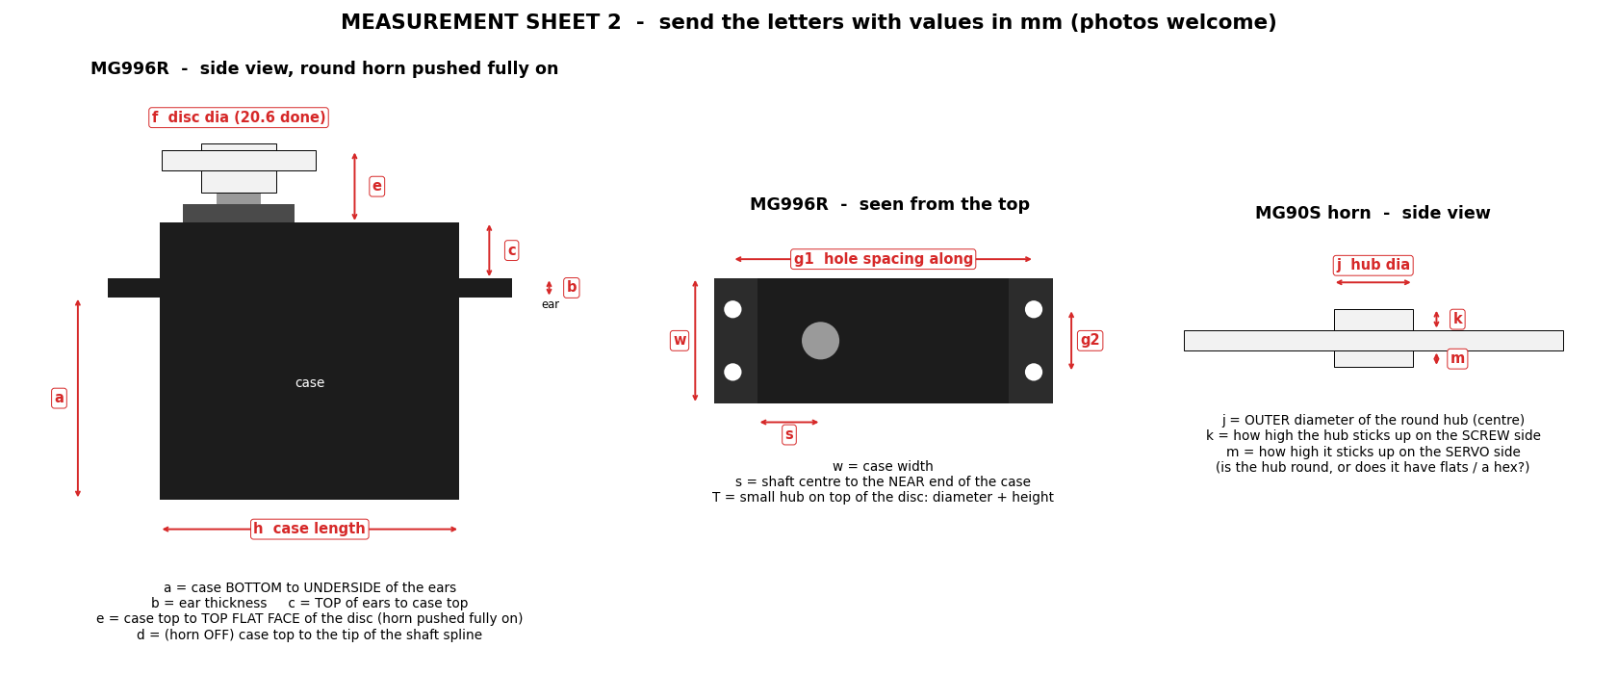
docs/guides/MEASURE_SHEET_2.png
