vibheshmodgil/gimbal/(commit log)

2026-10-19 Checkpoint: gimbal project as of 2026-10-19 (fw 3.4 mount calibration, single tracker UI)
    [1_fit_test_round3_A1.3mf, 1_fit_test_round4_A1.3mf, 2_FINAL_head_yoke_A1.3mf, 3_FINAL_base_A1.3mf, 4_FINAL_bottom_plate_A1.3mf, 5_REPRINT_axle_pin_A1.3mf, SG90_MG90S_2arm_horn_FreeCAD.step, SG90_MG90S_servo_FreeCAD.step]
2026-10-19 Gimbal device service: validated motion, stop, survey, observations, events
    host/gimbal_service: HTTP/JSON + SSE adapter over the unchanged firmware protocol
    (WS :81, MJPEG :82) with a firmware-faithful mock. Contract proposal v0 as JSON
    Schema; 44 mock/contract tests; real-hardware validation recorded in
    host/test_results. Tracker gains --stream-url to share the adapter's stream.
2026-10-19 Conform gimbal service to canonical Robotics Device API v1 (c1fc274)
    Envelope on every JSON response, epoch timestamps, /v1/info, /v1/commands
    (idempotent, deadline_s), /v1/stop, operation_result/observation/room_event
    shapes, detections ingest + observations/latest, frame.jpg. Canonical schemas
    vendored in host/contracts/v1; 57 tests incl. the orchestrator's conformance
    checker. check_device over HTTP: PASS.
2026-10-19 Tracker: face aim, fast stop-and-look search, brownout-safe moves, safe limits; fw 3.5 OLED moods
    - Aim at the face (yolo11n-pose nose/eyes), box aim height only when the face isn't visible
    - Search: starts 1.5 s after loss (was 4.2 s), looks where the person was heading first,
    ramped jumps between overlapping views with a still dwell (was a slow blurry sweep, 6-17 s)
    - Lock handoff to a track that appears after the locked one vanished (no 4 s freeze)
    - Pause + 'GIMBAL NOT RESPONDING' when status is stale (brownout reboot), resume from real pose
    - Limits: firmware soft AND servo reach AND CAD +-90/45 (firmware alone allowed pan 163)
    - Firmware 3.5: OLED eye moods (MOOD:HAPPY|SEARCH|SAD|SUR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
    [config.h, oled.cpp, oled.h, web.cpp]
2026-10-19 Tracker pushes detections to the device service; service can push room events to a webhook
    - Tracker --device-url: newest perception.detections (yolo11n-pose boxes + bearings) <= 4/s, one-slot sender
    - Service GIMBAL_EVENT_WEBHOOK: POST each room_event (presence_started/ended ...) fire-and-forget
    - Verified with real YOLO detections from the live tracker into the service (mock link): 2 people, 0.57 s old
2026-10-20 Jetson Orin Nano guide; tracker --host flag; ignore logs
2026-10-20 JETSON.md: real clone URL
